AutomationArt/LoraType/README.md

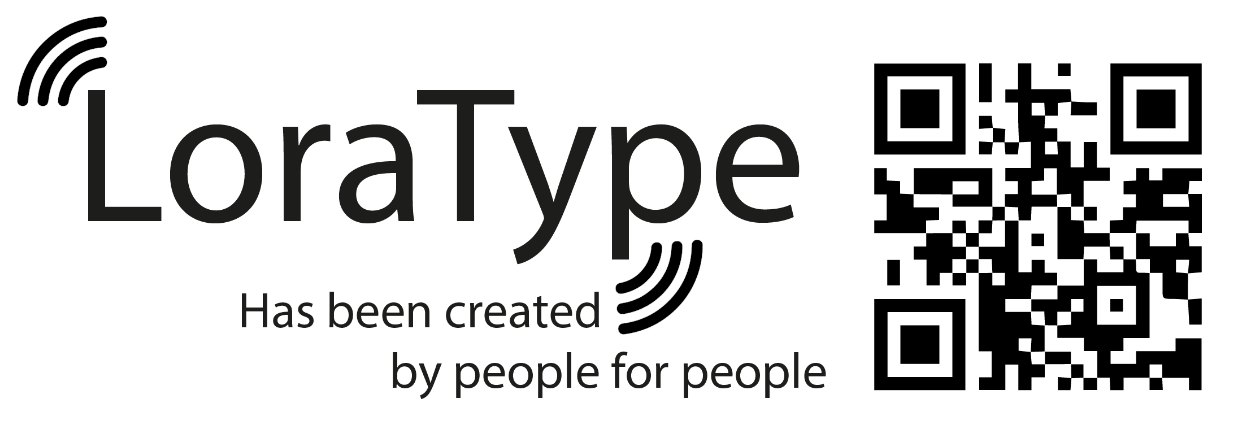
[picture p1: Image/LoraType.png]
LoraType


### NEWS LoraType...| 08.10.2024

Hello everyone! Straight to the point: we've integrated new OTA updates. Now you can update firmware locally, independent of the internet and the availability of an online service. We’ve integrated [ElegantOTA](https://github.com/ayushsharma82/ElegantOTA) (an OTA server runs on the device, and you can conveniently upload your modified firmware — it's made by people for people).
We invite everyone to test, develop, innovate, and especially mesh protocol nerds!
For testing, you can purchase devices at our local store: [shop.automation.art](https://shop.automation.art/products/radio-868mhz-mesendzher-tekstova-ratsiya-loratype-prototip/)

### Previous News

- We are on  [Fosstodon](https://fosstodon.org/@loratype "Fosstodon")  
- We built a second version of the case
- We have assembled a batch of devices (**50 pcs**)
- New video of how it works! [https://youtu.be/M7Vq4bjurBg](https://youtu.be/M7Vq4bjurBg "https://youtu.be/M7Vq4bjurBg")
- We are adding new code to the project 
- We sent the devices to users for testing (USA, Germany, Armenia)
- In contact with @meshtastic, sent them devices to start joint integration 
- We welcome comments and suggestions 😊

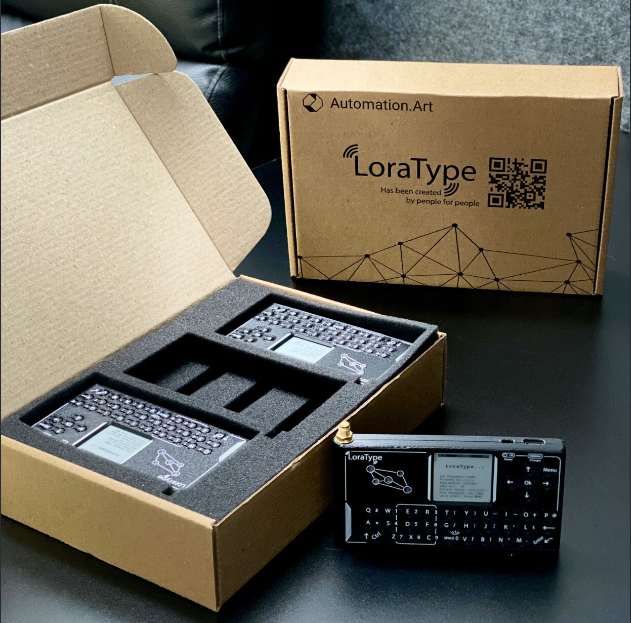
[picture p2: Image/LoratypeNP3.png]
LoraType LoraType2

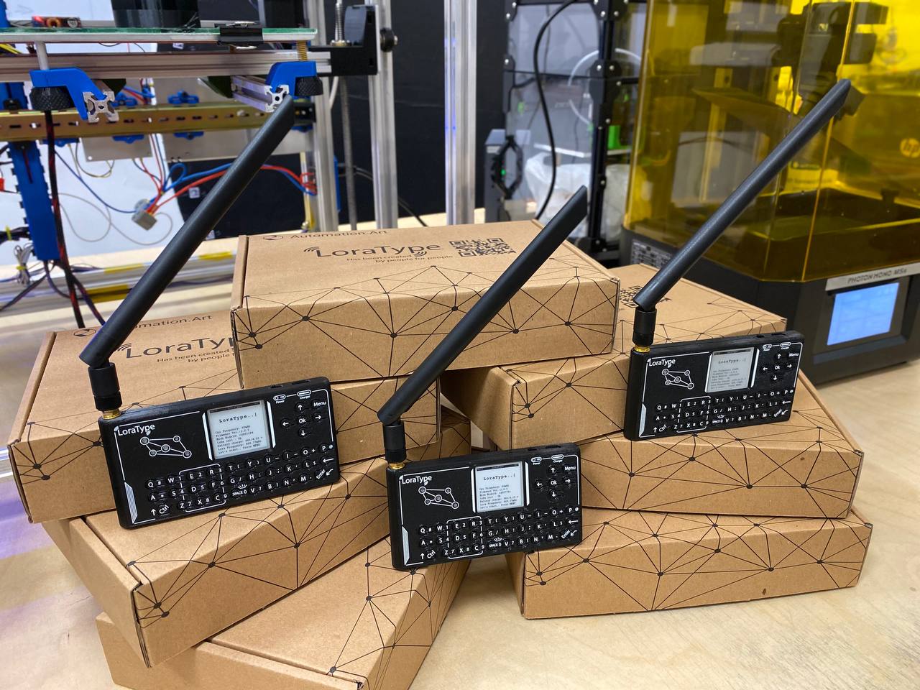
[picture p3: Image/LoraTypeNP1.jpg]
LoraType LoraType1


### LoraType
Our priority is to make the user experience as simple as possible. It only has an on/off button, a widespread QWERTY-keyboard and a cute e-ink display. That’s it. However, in spite of simplicity the Loratype can be used as a tiny PC with possibility for programming and adding new functions thanks to embedded Wі-Fі, Bluetooth and esp32. Welcome on board and feel like home, dear like-minded fellows!

There are some extra features: the LoRa protocol is noise-resistant, and the communication range is about 1 km in a city and up to 7 km in line-of-sight coverage. And of course it is totally free of charge, Loratype has been created not by a Corporation for population, but by people for people. Thus, in any emergency condition, we will honorably stay together!

### How Does it Work?
1. Turn on the device
2. Wait a moment (search for interlocutors in the mesh network)
3. Chat, stay in touch without paying for traffic!

### Device features
- Free of charge (Lora user doesn't need to pay for the service)
- Autonomous device (LoraType to be completely autonomous)
- Independed of internet, 5G, GSM etc. (Stay connected without Internet!)

### Use cases
- During disasters like earthquakes, floods, hurricanes, and fires among others
- Hiking or camping far away from cities, receptions etc
- In a war zone or mass protests (when government could shut down the internet)
- When you need free messaging (your plan is expired or you do not have a mobile data on your phone)

### Security
LoRa contains all the basic building blocks needed and used by any modern wireless technology, and it does so using the AES-128 standard. ([Lora Security](https://lora-alliance.org/wp-content/uploads/2020/11/lorawan_security_whitepaper.pdf "Lora Security"))

------------
### We have gone through several important stages of product development.

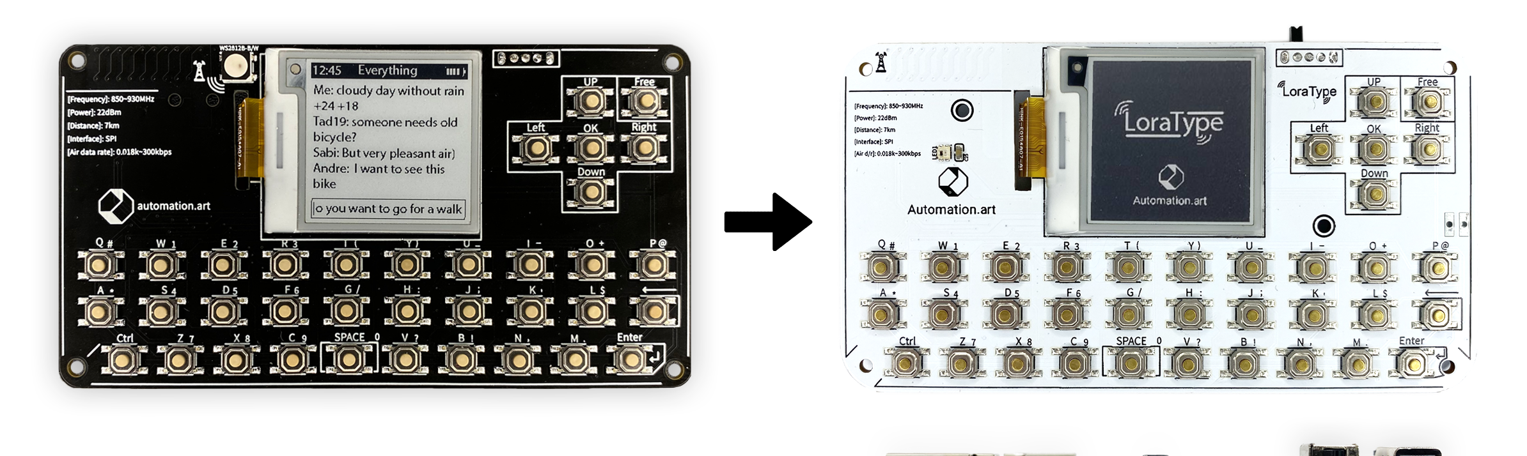
[picture p4: Image/LoraType_v1tov2.png]
LoraType LoraTypePCB


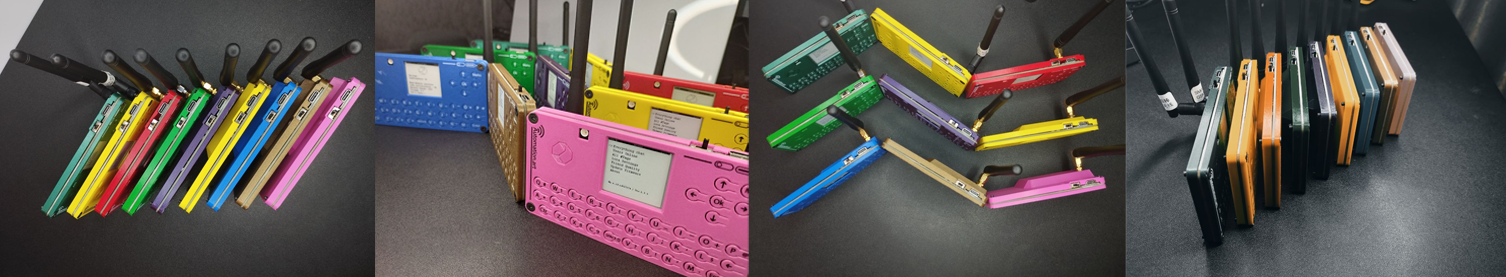
[picture p5: 3D model - Case/V1/LoraType_FirstCase.png]
LoraType_Case LoraTypePCB


------------

### Current PCB release

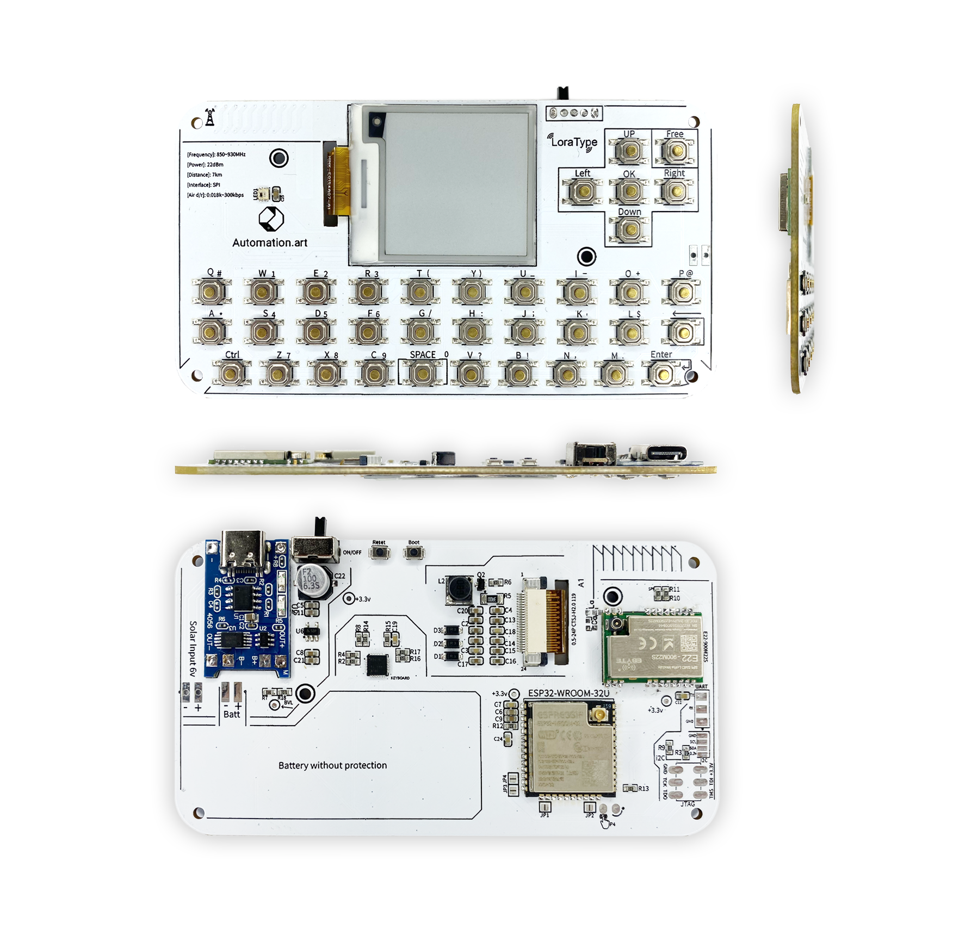
[picture p6: Image/LoraType_PCB.png]
LoraType LoraTypePCB


### Specifications

|  Component | Description  |
| --- | --- |
| **Display**  | Durable low power screen that can store information for up to 6 months without consuming power (1.54 inch e-paper display module partial refresh E-ink screen, [GDEH0154D67](https://www.good-display.com/product/1.54-inch-e-paper-display-module-partial-refresh-E-ink-screen,-GDEH0154D67-208.html "GDEH0154D67")) |
| **Main controller** | The [ESP32](https://www.espressif.com/sites/default/files/documentation/esp32-wroom-32e_esp32-wroom-32ue_datasheet_en.pdf "ESP32") module gives the device great advantages in development and functionality. You only need to replace the firmware over the air |
| **Lora Module**  | The [E22](https://www.ebyte.com/en/product-view-news.aspx?id=437 "E22") series is the first wireless module in China to adopt Semtech's SX1262, SX1268 RF chip. This chip provides a variety of modulation methods, such as LoRaTM and traditional GFSK. Its special LoRaTM modulation method increases the communication distance. |
| **Keyboard** | [TCA8418RTWR](https://www.ti.com/product/TCA8418/part-details/TCA8418RTWR "TCA8418RTWR") Great built-in simultaneous click capabilities. Keyboard with built-in protection against electrostatic discharge |
| **Charger**| [TP4056](http://www.tp4056.com/datasheet/ "TP4056") Proven by time and many users. Has battery protection. Battery will last longer |
| **LDO regulator**  | [AP2112](https://www.digikey.com/en/products/detail/diodes-incorporated/AP2112K-3-3TRG1/4470746 "AP2112") is CMOS low dropout linear regulator 600мА  |
| **ARGB Led**  | [WS2912b-2020](https://www.tme.eu/Document/8b264124130de6e17f8ce807c3210601/WS2812B-2020.pdf "WS2912b-2020") is an intelligent control LED light source  |

##### We used good solutions from Good Display, Espressif, Texas Instruments

### Additional features for the community

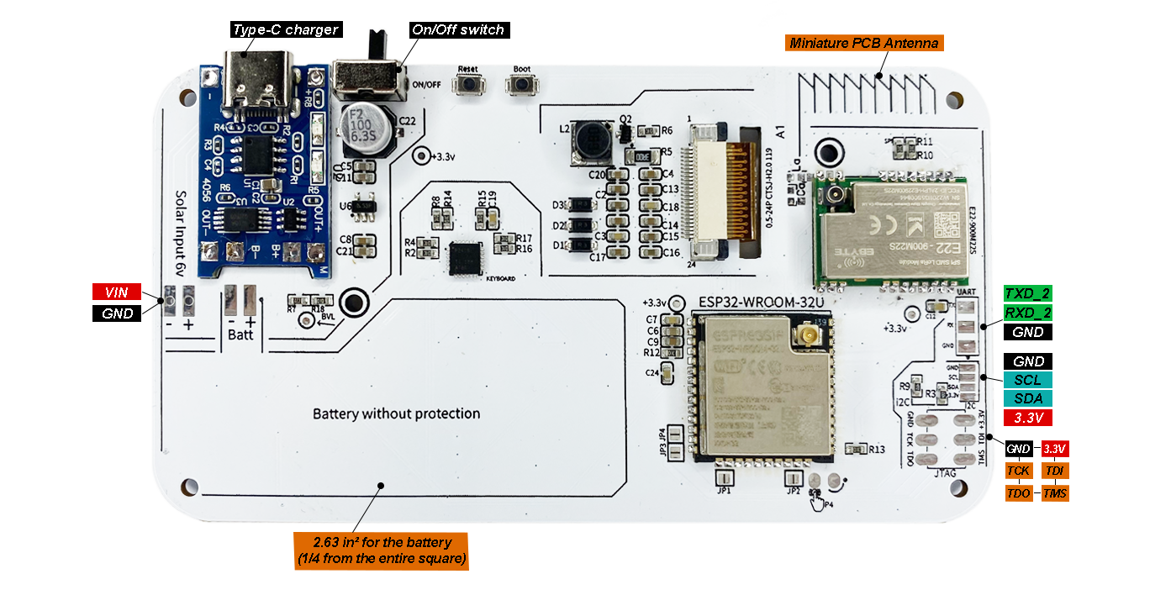
[picture p7: Image/LoraType_ForDIY.png]
LoraTypeForDiy


**For device owners, the ability to add DIY add-ons is available.**
- Fast flash firmware (UART)
- Adding your own sensors to the device (via I2C bus)
- JTAG debugging
- Replaceable battery (Li-po)
- Using integrated antenna
- Connection of external power generators (Energy harvesters)

**Main controller features:**

- Support Wi-Fi + Bluetooth® + Bluetooth LE
- WiFi Standards: FCC/CE/IC/TELEC/KCC/SRRC/NCC
- Protocols: 802.11 b/g/n/d/e/i/k/r (802.11n up to 150Mbps)
- Support Wi-Fi Modes: Client, Access Point, Sniffer, Wi-Fi Direct
- Integrated SPI flash: 4 MB
- Security: WPA/WPA2/WPA2-Enterprise/WPS
- Encryption: AES/RSA/ECC/SHA
- Network protocols: IPv4, IPv6, SSL, TCP/UDP/HTTP/FTP/MQTT
- Software update over the air

Built-in radio module (SX1262) allows additional various radio communication methods ([RadioLibrary](https://github.com/jgromes/RadioLib/tree/master/examples "RadioLibrary")):  [AFSK](https://en.wikipedia.org/wiki/Frequency-shift_keying "AFSK"), [APRS](https://en.wikipedia.org/wiki/Automatic_Packet_Reporting_System "APRS"), [AX25](https://en.wikipedia.org/wiki/AX.25 "AX25"), FSK4, [Hellschreiber](https://en.wikipedia.org/wiki/Hellschreiber "Hellschreiber,"),[ Morse](https://en.wikipedia.org/wiki/Morse_code " Morse"), [RTTY](https://en.wikipedia.org/wiki/Radioteletype "RTTY"), [SSTV](https://en.wikipedia.org/wiki/Slow-scan_television "SSTV")                        

------------
### Comparisons             
| #| LoraType  |  RippleQWERTY  | ArmaChat | LoRa Msg  | ESPboy LORA  |
| --- | --- | --- | --- | --- | --- |
| **Open Source** |  yes |  yes | yes |  yes | yes  |
| **Transceiver** | SX1262  | SX1276  | RFM95W | RFM95W  | SX1278  |
| **Transmit Power** | 22 dbm  | 19.5 dBm | 20 dbm  | 20 dbm  |  30dBm  |
| **Display** | E-Ink  | OLED  | TFT  | TFT |  TFT  |
|  **Battery** | Li-po 1100mA  | It is not specified exactly  | 18650  | 1500mA |  It is not specified exactly  |
|  **Num. of buttons** |  36 |  35  |  30  |  35  |  6  |
|  **Wi-Fi** |  yes |  yes  |  no  |  no  |  yes  |
|  **Bluetooth** | yes  |  yes  | no | no |  no |
|  **Case** |  yes (choice is available+stl) |  yes (+stl)  |  pcb case  | yes (+stl) |  yes (+stl)  |
|  **Dimensions** |  110mm*60mm | not specify |  76mm x 71mm | 70mm*105mm  |  90mm*50mm | 

------------

### Support & Documentation
**This project is open source. We opened all circuits and software**
  
- [Getting Started DIY here](https://github.com/AutomationArt/LoraType/tree/main/GettingStarted "Getting Started DIY here")  :white_check_mark:
- [STL models for cases](https://github.com/AutomationArt/LoraType/tree/main/3D%20model%20-%20Case "STL models for cases") 
- [Components Documentation](https://github.com/AutomationArt/LoraType/tree/main/Documents "Component Documentation") :fire:
- [Software Example](https://github.com/AutomationArt/LoraType/tree/main/Software "Software Example")
- On-line Support
- [Instagram](https://www.instagram.com/automation_art "Instagram") | [Fosstodon](https://fosstodon.org/@loratype "Fosstodon")

<a rel="me" href="https://fosstodon.org/@loratype">Fosstodon</a>
