AutomationArt/LoraType/3D model - Case/README.md

LoraType

### LoraType..|

Cases and models for 3D printing LoraType
