AutomationArt/LoraType/3D model - Case/V1/README.md

LoraType

### LoraType..|

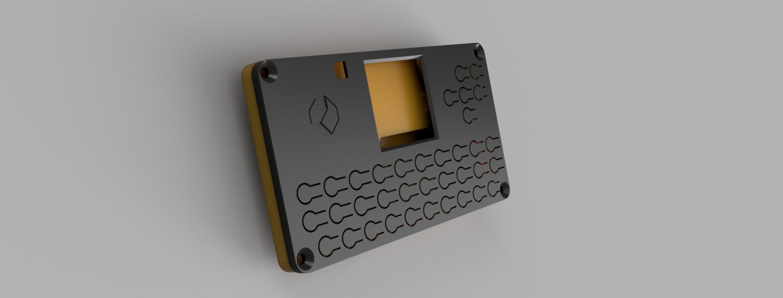
[picture p8: 3D model - Case/V1/Lora 0.2 v2.png]
LoraType Case v1


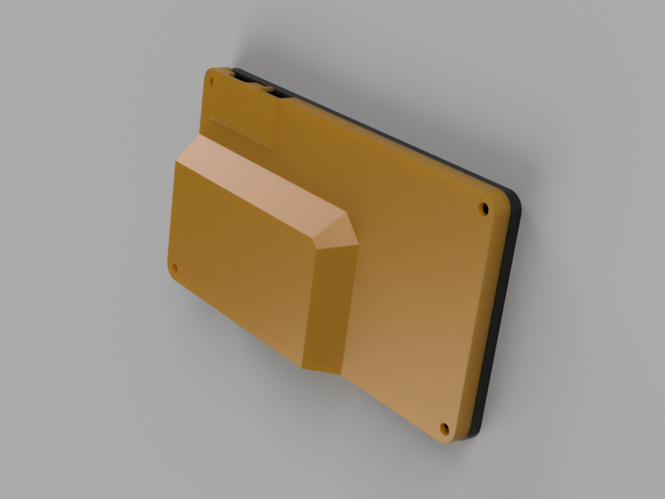
[picture p9: 3D model - Case/V1/Lora 0.2 v21.png]
LoraType Case v1


LoraType Case v1 LoraType Case 3D

[Download STEP file](https://github.com/AutomationArt/LoraType/blob/main/3D%20model%20-%20Case/V1/Lora%200.2%20v2.step "Download STEP file")
