AutomationArt/LoraType/Video/README.md

LoraType
### LoraType..|

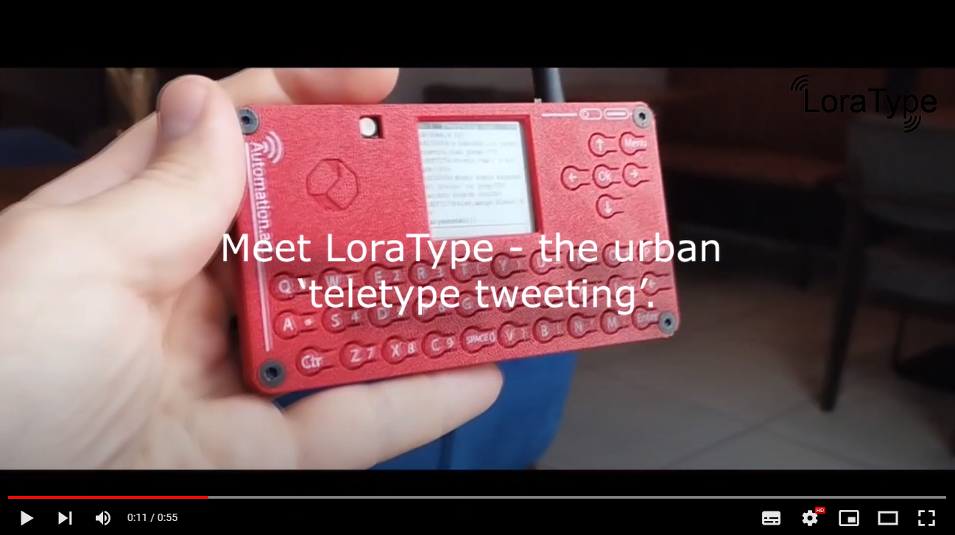
[picture p10: Image/VideoLoraType.png]
LoraType (https://youtu.be/F7qizRmNL4o)
