AutomationArt/LoraType/3D model - Case/V2-Rounded/LoraType_v2_case2.jpg

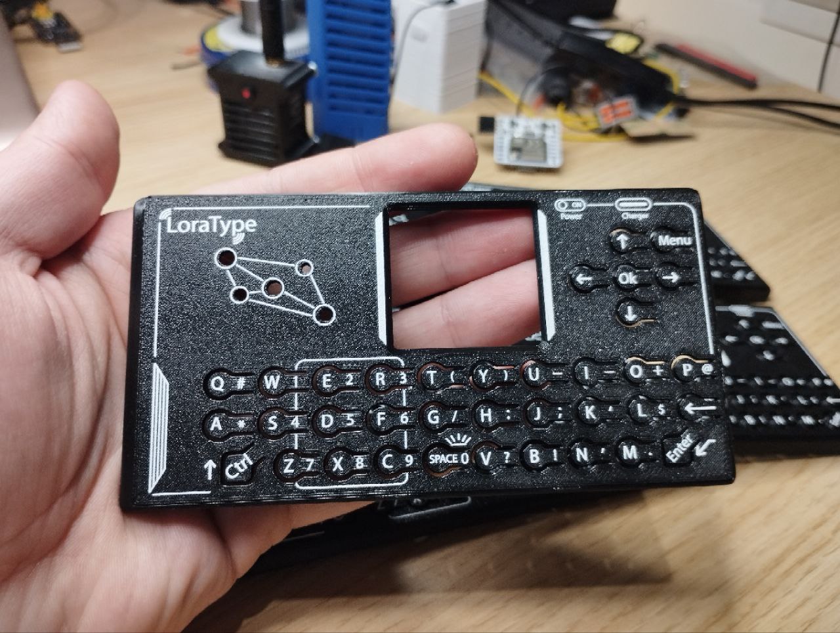
3D model - Case/V2-Rounded/LoraType_v2_case2.jpg
