AutomationArt/LoraType/3D model - Case/V2-Rounded/LoraType_v2_case.jpg

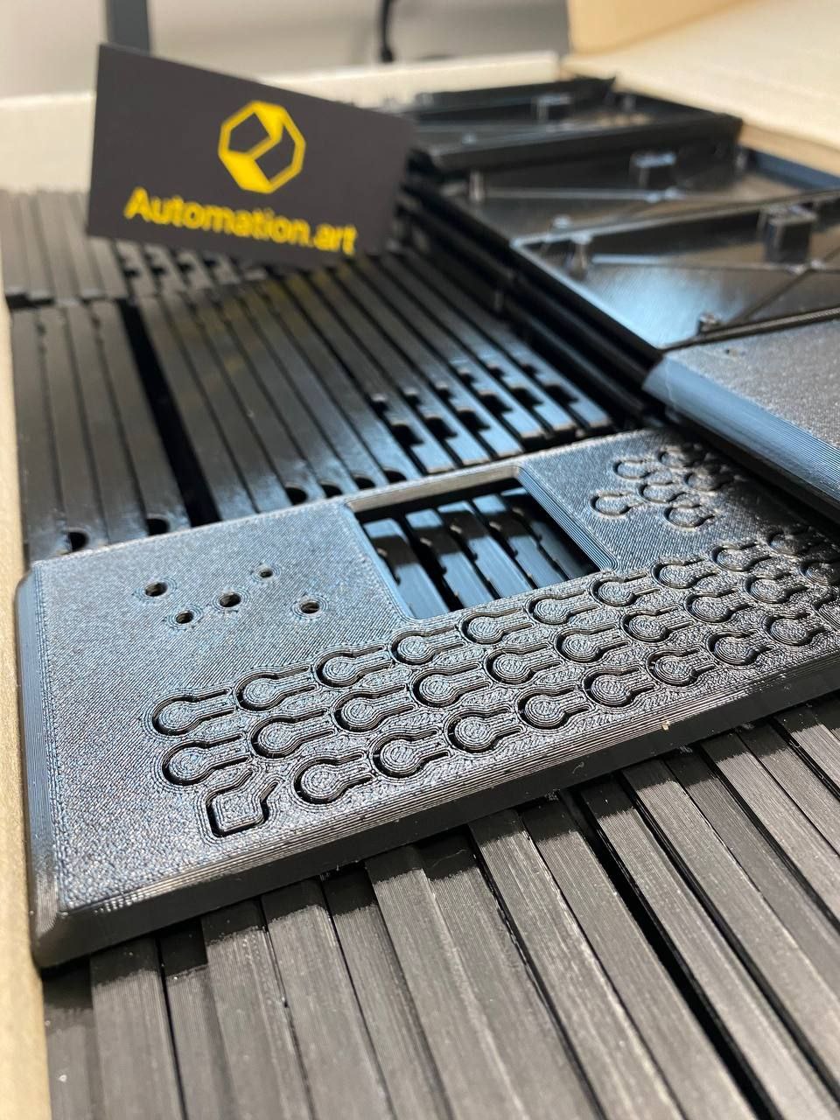
3D model - Case/V2-Rounded/LoraType_v2_case.jpg
