AutomationArt/LoraType/Design stages/v4/LoraType_v4.jpg

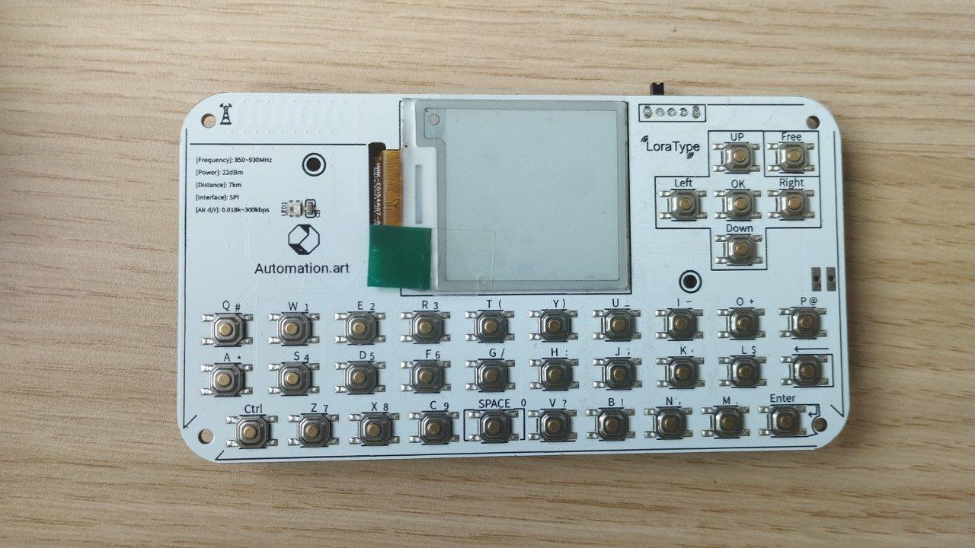
Design stages/v4/LoraType_v4.jpg
