AutomationArt/LoraType/Design stages/v4/LoraType_v4.png

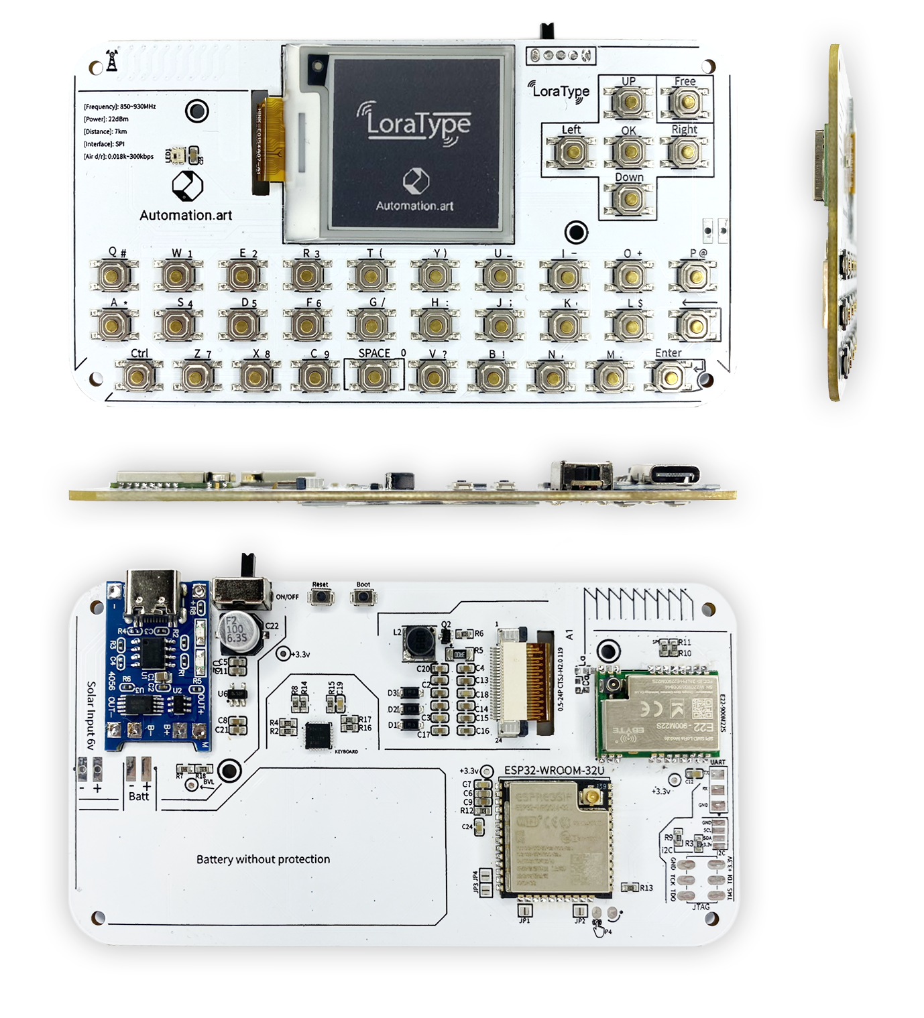
Design stages/v4/LoraType_v4.png
