AutomationArt/LoraType/Design stages/v4/LoraType_v4_box.png

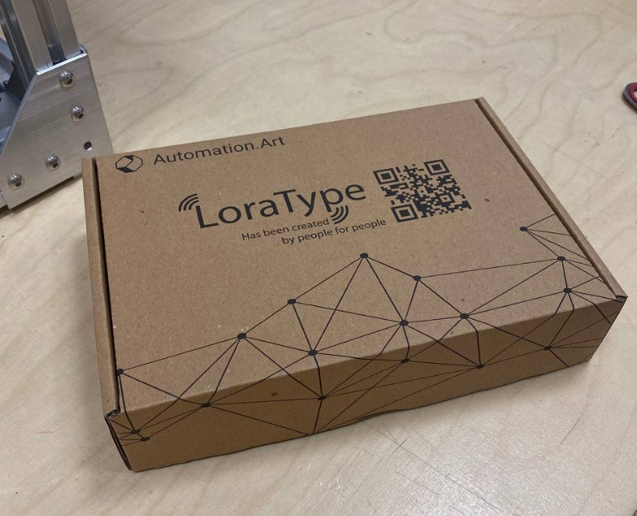
Design stages/v4/LoraType_v4_box.png
