AutomationArt/LoraType/Image/LoraType_PCB_1.png

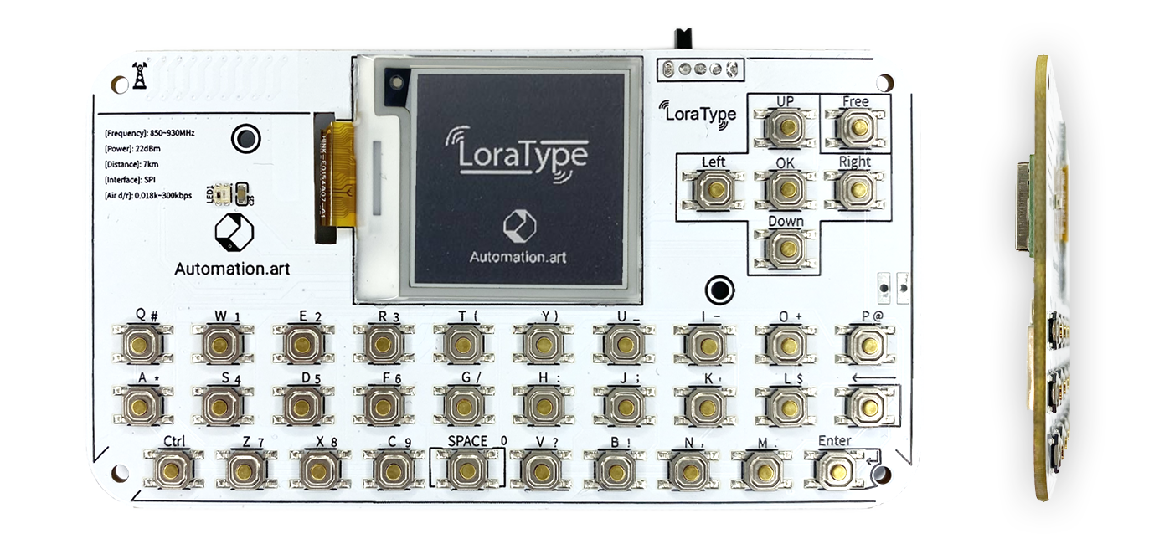
Image/LoraType_PCB_1.png
