AutomationArt/LoraType/Image/LoraType_PCB_3.jpg

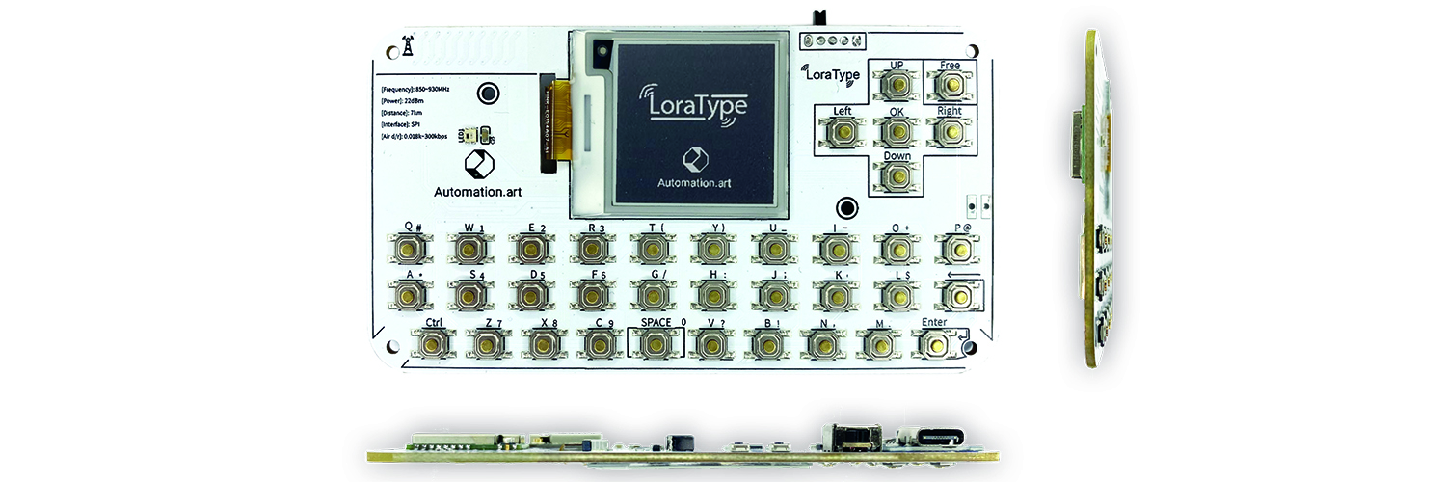
Image/LoraType_PCB_3.jpg
