AutomationArt/LoraType/Image/LoraTypeNP2.jpg

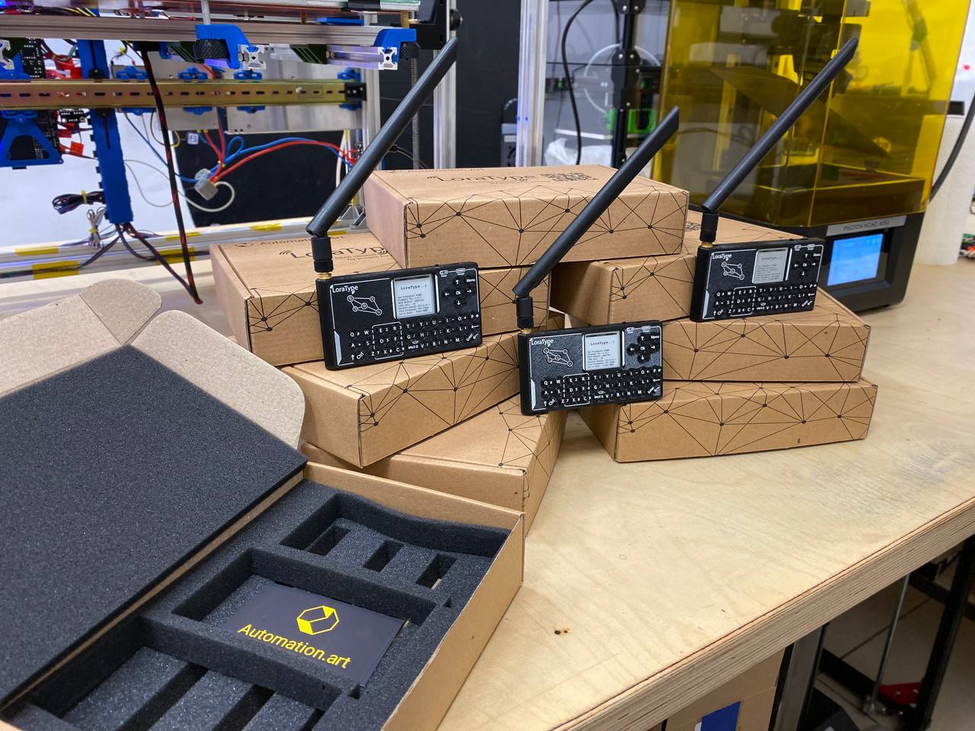
Image/LoraTypeNP2.jpg
