AutomationArt/LoraType/Image/LoratypeNP3.jpeg

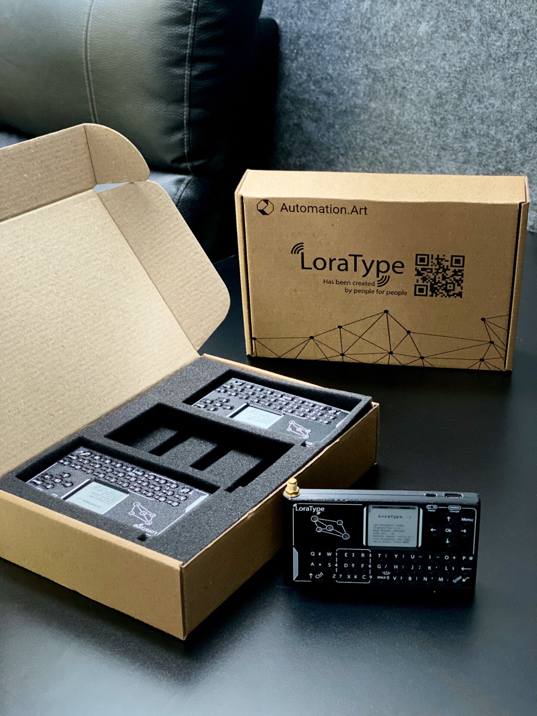
Image/LoratypeNP3.jpeg
