AutomationArt/LoraType/Electronics/BOM_PCB_LoraType.csv

ID | Name | Designator | Footprint | Quantity | Manufacturer Part | Manufacturer | Supplier | Supplier Part | Price | Pins | 3DModel | Contributor | Package Display | Pitch | Resistance | Resistance (Ohms) | link
1 | Boot | SW3 | SW-SMD_L3.1-W2.5-LS4.0 | 1 | GT-TC032A-H015-L1 | G-Switch(品赞) | LCSC | C843684 | 0.028 | 2 | SW-SMD_L3.1-W2.5-LS4.0 | LCSC |  |  |  |  | https://item.szlcsc.com/902796.html
2 | TP4056_MODULE COPY | U2 | TP4056MODULE | 1 |  |  |  |  |  | 6 |  | David Lochlin
3 | 27kΩ | R7 | R0603 | 1 | 0603WAF2702T5E | UniOhm | LCSC | C22967 |  | 2 | R0603_L1.6-W0.8-H0.8 | lcsc |  |  |  | 27K | https://www.mouser.in/datasheet/2/447/PYu_RT_1_to_0_01_RoHS_L_11-1669912.pdf
4 | 100kΩ | R18 | R0603 | 1 | 0603WAF1003T5E | UniOhm | LCSC | C25803 |  | 2 | R0603_L1.6-W0.8-H0.8 | lcsc |  |  |  | 100K | https://www.mouser.in/datasheet/2/447/PYu_RT_1_to_0_01_RoHS_L_11-1669912.pdf
5 | 0.5-24P CTSJ-H2.0 119 | FPC2 | FPC-SMD_24P-P0.50_SHOU-HAN_CTSJ-H2.0 | 1 | 0.5-24P CTSJ-H2.0 119 | SHOU HAN(首韩) | LCSC | C2858299 | 0.014 | 26 | FPC-SMD_P0.50-WS-24P COPY | LCSC |  |  |  |  | https://atta.szlcsc.com/upload/public/pdf/source/20210802/C2858299_F4888E2D4248D884D4956E549F7AA773.pdf
6 | JTAG | J1 | 2X3P-2.54-SMD | 1 |  |  |  |  |  | 6 |  | thedome712
7 | Reset | SW2 | SW-SMD_L3.1-W2.5-LS4.0 | 1 | GT-TC032A-H015-L1 | G-Switch(品赞) | LCSC | C843684 | 0.028 | 2 | SW-SMD_L3.1-W2.5-LS4.0 | LCSC |  |  |  |  | https://item.szlcsc.com/902796.html
8 | SWITCH | ON/OFF | SW-TH_SK12D07VG4 | 1 | SK12D07VG4 | SHOU HAN | LCSC | C393937 | 0.003 | 5 | SW-TH_L8.7-W4.4-H4.0-P2.0 | LCSC | No |  |  |  | https://item.szlcsc.com/372549.html
9 | 10kΩ | R15,R4,R8,R14,R16,R17,R6,R12,R13,R10,R11 | R0603 | 11 | 0603WAF1002T5E | UniOhm | LCSC | C25804 |  | 2 | R0603_L1.6-W0.8-H0.8 | lcsc | Yes |  |  | 10K | https://www.mouser.in/datasheet/2/447/PYu_RT_1_to_0_01_RoHS_L_11-1669912.pdf
10 | 100nF | C19 | C0603 | 1 | CL10B104KA8NNNC | SAMSUNG | LCSC | C1590 |  | 2 | C0603_L1.6-W0.8-H0.8 | lcsc | No |  |  |  | https://item.szlcsc.com/362304.html
11 | 10kΩ | R2 | R0603 | 1 | 0402WAF1002T5E | UniOhm | LCSC | C25804 |  | 2 | R0603_L1.6-W0.8-H0.8 | lcsc | Yes |  |  | 10K | https://www.mouser.in/datasheet/2/447/PYu_RT_1_to_0_01_RoHS_L_11-1669912.pdf
12 | TCA8418RTWR | KEYBOARD | WQFN-24_L4.0-W4.0-P0.50-TL-EP2.5 | 1 | TCA8418RTWR | Texas Instruments | LCSC | C138713 | 0.342 | 25 | WQFN-24_L4.0-W4.0-H0.8-P0.50 | LCSC | No |  |  |  | https://item.szlcsc.com/420260.html
13 | 10uF | C5,C21,C6 | C0603 | 3 | CL10A106KP8NNNC | SAMSUNG | LCSC | C19702 | 0.001 | 2 | C0603_L1.6-W0.8-H0.8 | lcsc | Yes |  |  |  | https://item.szlcsc.com/362304.html
14 | 1uF | C8,C11,C2,C10,C1,C4,C9,C13,C14,C15,C16,C17 | C0603 | 12 | CL10A105KB8NNNC | SAMSUNG | LCSC | C15849 | 0.001 | 2 | C0603_L1.6-W0.8-H0.8 | lcsc | Yes |  |  |  | https://item.szlcsc.com/362304.html
15 | 100uF | C22 | CAP-SMD_BD6.3-L6.6-W6.6-FD | 1 | UZG0J101MCL1GB | Nichicon | LCSC | C134238 | 0.061 | 2 | CAP-SMD_BD6.3-L6.6-W6.6-FD | LCSC | No |  |  |  | https://item.szlcsc.com/265679.html
16 | MBR0530 | D1,D2,D3 | SOD-123_L2.8-W1.8-LS3.7-RD | 3 | MBR0530 | CJ | LCSC | C77336 | 0.005 | 2 | SOD-123_L2.8-W1.8-LS3.7-RD | lcsc | No |  |  |  | https://item.szlcsc.com/301422.html
17 | SI1308EDL-T1-GE3 | Q2 | SOT-323_L2.0-W1.3-P1.30-LS2.1-BR | 1 | SI1308EDL-T1-GE3 | VISHAY(威世) | LCSC | C469327 | 0.114 | 3 | SOT-323_L2.0-W1.3-H1.0-LS2.1-P1.30 | LCSC | No |  |  |  | https://item.szlcsc.com/94230.html
18 | AP2112K-3.3TRG1 | U6 | SOT-25-5_L3.0-W1.8-P0.95-LS3.0-BR | 1 | AP2112K-3.3TRG1 | DIODES | LCSC | C51118 | 0.038 | 5 | SOT-25-5_L3.0-W1.6-H1.3-LS2.8-P0.95 | LCSC | No |  |  |  | https://item.szlcsc.com/70677.html
19 | 68uH | L2 | IND-SMD_L4.7-W4.7 | 1 | SCDS4D18T-680M-S-N | Chilisin Elec | LCSC | C338798 | 0.027 | 2 | IND-SMD_L4.7-W4.7-H2.0 | LCSC |  |  |  |  | https://item.szlcsc.com/198690.html
20 | 100nF | C3,C7,C18,C24,C12,C25 | C0603 | 6 | CL10B104KA8NNNC | SAMSUNG | LCSC | C1590 |  | 2 | C0603_L1.6-W0.8-H0.8 | lcsc | Yes |  |  |  | https://item.szlcsc.com/362304.html
21 | 4.7uF | C20 | C0603 | 1 | CL10A475KO8NNNC | SAMSUNG | LCSC | C19666 | 0.001 | 2 | C0603_L1.6-W0.8-H0.8 | lcsc | Yes |  |  |  | https://item.szlcsc.com/362304.html
22 | 4.7K | R3,R9 | R0603 | 2 | 0603WAJ0472T5E_C145172 | UniOhm | LCSC | C145172 |  | 2 | R0603_L1.6-W0.8-H0.8 | lcsc | Yes |  |  |  | https://www.mouser.in/datasheet/2/447/PYu_RT_1_to_0_01_RoHS_L_11-1669912.pdf
23 | 3Ω | R5 | R1206 | 1 | RT1206FRE073RL | YAGEO | LCSC | C728697 | 0.003 | 2 | R1206_L3.2-W1.6-H0.6 | LCSC | Yes |  | 3Ω |  | https://item.szlcsc.com/311874.html
24 | ESP32-WROOM-32U | U5 | ESP32-WROOM-32U | 1 | ESP32-WROOM-32UE(4MB) | Espressif Systems | LCSC | C701344 | 0.453 | 39 | WIFI-SMD_L19.2-18.0-H3.2-ESP32-WROOM-32UE | Ivan P | No |  |  |  | https://www.espressif.com/sites/default/files/documentation/esp32-wroom-32d_esp32-wroom-32u_datasheet_en.pdf
25 | E22-900M22S | U3 | WIRELM-SMD_E22-900M22S | 1 | E22-900M22S | Chengdu Ebyte Elec Tech | LCSC | C411293 | 1.102 | 22 | WIRELM-SMD_L20.0-W14.0-H3.0-E22-900M22S | LCSC | No |  |  |  | https://item.szlcsc.com/402604.html
26 | LORATYPE_HELICAL PCB ANTENNA 868 | A1 | HELICAL_PCB_ANTENNA_19X12MM_WITH_GND_AND_MATCH | 1 |  |  |  |  |  | 2 |  | piotro2012
27 | 3 PIN SMD HEADER AV | UART | 3 PIN SMD HEADER | 1 |  |  |  |  |  | 3 |  | szegabesz |  | 2.54
28 | WS2812B-2020 | LED1 | LED-SMD_4P-L2.0-W2.0-TL_WS2812B-2020 | 1 | WS2812B-2020 | worldsemi | LCSC | C965555 | 0.017 | 4 | LED-SMD_4P-L2.0-W2.0-H0.8-TL_WS2812B-2020 | LCSC |  |  |  |  | https://item.szlcsc.com/1051115.html?ref=editor&logined=true
29 | UP | 29 | SW-SMD_4P-L5.2-W5.2-P3.70-LS6.5 | 1 | 4*4*1.7Plastic head waterproof,260G, 0.25mm,SMD | BBJ | LCSC | C10852 | 0.003 | 4 | SW-SMD_4P-L5.2-W5.2-H1.5-LS6.4-P3.70 | 立创EDA官方封装库 | No |  |  |  | https://lcsc.com/product-detail/Tactile-Switches_BOOMELE-Boom-Precision-Elec-4-4-1-7_C10852.html
30 | I | 1 | SW-SMD_4P-L5.2-W5.2-P3.70-LS6.5 | 1 | 4*4*1.7Plastic head waterproof,260G, 0.25mm,SMD | BBJ | LCSC | C10852 | 0.003 | 4 | SW-SMD_4P-L5.2-W5.2-H1.5-LS6.4-P3.70 | 立创EDA官方封装库 | No |  |  |  | https://lcsc.com/product-detail/Tactile-Switches_BOOMELE-Boom-Precision-Elec-4-4-1-7_C10852.html
31 | U | 2 | SW-SMD_4P-L5.2-W5.2-P3.70-LS6.5 | 1 | 4*4*1.7Plastic head waterproof,260G, 0.25mm,SMD | BBJ | LCSC | C10852 | 0.003 | 4 | SW-SMD_4P-L5.2-W5.2-H1.5-LS6.4-P3.70 | 立创EDA官方封装库 | No |  |  |  | https://lcsc.com/product-detail/Tactile-Switches_BOOMELE-Boom-Precision-Elec-4-4-1-7_C10852.html
32 | Y | 3 | SW-SMD_4P-L5.2-W5.2-P3.70-LS6.5 | 1 | 4*4*1.7Plastic head waterproof,260G, 0.25mm,SMD | BBJ | LCSC | C10852 | 0.003 | 4 | SW-SMD_4P-L5.2-W5.2-H1.5-LS6.4-P3.70 | 立创EDA官方封装库 | No |  |  |  | https://lcsc.com/product-detail/Tactile-Switches_BOOMELE-Boom-Precision-Elec-4-4-1-7_C10852.html
33 | T | 4 | SW-SMD_4P-L5.2-W5.2-P3.70-LS6.5 | 1 | 4*4*1.7Plastic head waterproof,260G, 0.25mm,SMD | BBJ | LCSC | C10852 | 0.003 | 4 | SW-SMD_4P-L5.2-W5.2-H1.5-LS6.4-P3.70 | 立创EDA官方封装库 | No |  |  |  | https://lcsc.com/product-detail/Tactile-Switches_BOOMELE-Boom-Precision-Elec-4-4-1-7_C10852.html
34 | R | 5 | SW-SMD_4P-L5.2-W5.2-P3.70-LS6.5 | 1 | 4*4*1.7Plastic head waterproof,260G, 0.25mm,SMD | BBJ | LCSC | C10852 | 0.003 | 4 | SW-SMD_4P-L5.2-W5.2-H1.5-LS6.4-P3.70 | 立创EDA官方封装库 | No |  |  |  | https://lcsc.com/product-detail/Tactile-Switches_BOOMELE-Boom-Precision-Elec-4-4-1-7_C10852.html
35 | E | 6 | SW-SMD_4P-L5.2-W5.2-P3.70-LS6.5 | 1 | 4*4*1.7Plastic head waterproof,260G, 0.25mm,SMD | BBJ | LCSC | C10852 | 0.003 | 4 | SW-SMD_4P-L5.2-W5.2-H1.5-LS6.4-P3.70 | 立创EDA官方封装库 | No |  |  |  | https://lcsc.com/product-detail/Tactile-Switches_BOOMELE-Boom-Precision-Elec-4-4-1-7_C10852.html
36 | W | 7 | SW-SMD_4P-L5.2-W5.2-P3.70-LS6.5 | 1 | 4*4*1.7Plastic head waterproof,260G, 0.25mm,SMD | BBJ | LCSC | C10852 | 0.003 | 4 | SW-SMD_4P-L5.2-W5.2-H1.5-LS6.4-P3.70 | 立创EDA官方封装库 | No |  |  |  | https://lcsc.com/product-detail/Tactile-Switches_BOOMELE-Boom-Precision-Elec-4-4-1-7_C10852.html
37 | Q | 8 | SW-SMD_4P-L5.2-W5.2-P3.70-LS6.5 | 1 | 4*4*1.7Plastic head waterproof,260G, 0.25mm,SMD | BBJ | LCSC | C10852 | 0.003 | 4 | SW-SMD_4P-L5.2-W5.2-H1.5-LS6.4-P3.70 | 立创EDA官方封装库 | No |  |  |  | https://lcsc.com/product-detail/Tactile-Switches_BOOMELE-Boom-Precision-Elec-4-4-1-7_C10852.html
38 | K | 9 | SW-SMD_4P-L5.2-W5.2-P3.70-LS6.5 | 1 | 4*4*1.7Plastic head waterproof,260G, 0.25mm,SMD | BBJ | LCSC | C10852 | 0.003 | 4 | SW-SMD_4P-L5.2-W5.2-H1.5-LS6.4-P3.70 | 立创EDA官方封装库 | No |  |  |  | https://lcsc.com/product-detail/Tactile-Switches_BOOMELE-Boom-Precision-Elec-4-4-1-7_C10852.html
39 | J | 10 | SW-SMD_4P-L5.2-W5.2-P3.70-LS6.5 | 1 | 4*4*1.7Plastic head waterproof,260G, 0.25mm,SMD | BBJ | LCSC | C10852 | 0.003 | 4 | SW-SMD_4P-L5.2-W5.2-H1.5-LS6.4-P3.70 | 立创EDA官方封装库 | No |  |  |  | https://lcsc.com/product-detail/Tactile-Switches_BOOMELE-Boom-Precision-Elec-4-4-1-7_C10852.html
40 | H | 11 | SW-SMD_4P-L5.2-W5.2-P3.70-LS6.5 | 1 | 4*4*1.7Plastic head waterproof,260G, 0.25mm,SMD | BBJ | LCSC | C10852 | 0.003 | 4 | SW-SMD_4P-L5.2-W5.2-H1.5-LS6.4-P3.70 | 立创EDA官方封装库 | No |  |  |  | https://lcsc.com/product-detail/Tactile-Switches_BOOMELE-Boom-Precision-Elec-4-4-1-7_C10852.html
41 | G | 12 | SW-SMD_4P-L5.2-W5.2-P3.70-LS6.5 | 1 | 4*4*1.7Plastic head waterproof,260G, 0.25mm,SMD | BBJ | LCSC | C10852 | 0.003 | 4 | SW-SMD_4P-L5.2-W5.2-H1.5-LS6.4-P3.70 | 立创EDA官方封装库 | No |  |  |  | https://lcsc.com/product-detail/Tactile-Switches_BOOMELE-Boom-Precision-Elec-4-4-1-7_C10852.html
42 | F | 13 | SW-SMD_4P-L5.2-W5.2-P3.70-LS6.5 | 1 | 4*4*1.7Plastic head waterproof,260G, 0.25mm,SMD | BBJ | LCSC | C10852 | 0.003 | 4 | SW-SMD_4P-L5.2-W5.2-H1.5-LS6.4-P3.70 | 立创EDA官方封装库 | No |  |  |  | https://lcsc.com/product-detail/Tactile-Switches_BOOMELE-Boom-Precision-Elec-4-4-1-7_C10852.html
43 | D | 14 | SW-SMD_4P-L5.2-W5.2-P3.70-LS6.5 | 1 | 4*4*1.7Plastic head waterproof,260G, 0.25mm,SMD | BBJ | LCSC | C10852 | 0.003 | 4 | SW-SMD_4P-L5.2-W5.2-H1.5-LS6.4-P3.70 | 立创EDA官方封装库 | No |  |  |  | https://lcsc.com/product-detail/Tactile-Switches_BOOMELE-Boom-Precision-Elec-4-4-1-7_C10852.html
44 | S | 15 | SW-SMD_4P-L5.2-W5.2-P3.70-LS6.5 | 1 | 4*4*1.7Plastic head waterproof,260G, 0.25mm,SMD | BBJ | LCSC | C10852 | 0.003 | 4 | SW-SMD_4P-L5.2-W5.2-H1.5-LS6.4-P3.70 | 立创EDA官方封装库 | No |  |  |  | https://lcsc.com/product-detail/Tactile-Switches_BOOMELE-Boom-Precision-Elec-4-4-1-7_C10852.html
45 | A | 16 | SW-SMD_4P-L5.2-W5.2-P3.70-LS6.5 | 1 | 4*4*1.7Plastic head waterproof,260G, 0.25mm,SMD | BBJ | LCSC | C10852 | 0.003 | 4 | SW-SMD_4P-L5.2-W5.2-H1.5-LS6.4-P3.70 | 立创EDA官方封装库 | No |  |  |  | https://lcsc.com/product-detail/Tactile-Switches_BOOMELE-Boom-Precision-Elec-4-4-1-7_C10852.html
46 | Down | 17 | SW-SMD_4P-L5.2-W5.2-P3.70-LS6.5 | 1 | 4*4*1.7Plastic head waterproof,260G, 0.25mm,SMD | BBJ | LCSC | C10852 | 0.003 | 4 | SW-SMD_4P-L5.2-W5.2-H1.5-LS6.4-P3.70 | 立创EDA官方封装库 | No |  |  |  | https://lcsc.com/product-detail/Tactile-Switches_BOOMELE-Boom-Precision-Elec-4-4-1-7_C10852.html
47 | B | 18 | SW-SMD_4P-L5.2-W5.2-P3.70-LS6.5 | 1 | 4*4*1.7Plastic head waterproof,260G, 0.25mm,SMD | BBJ | LCSC | C10852 | 0.003 | 4 | SW-SMD_4P-L5.2-W5.2-H1.5-LS6.4-P3.70 | 立创EDA官方封装库 | No |  |  |  | https://lcsc.com/product-detail/Tactile-Switches_BOOMELE-Boom-Precision-Elec-4-4-1-7_C10852.html
48 | V | 19 | SW-SMD_4P-L5.2-W5.2-P3.70-LS6.5 | 1 | 4*4*1.7Plastic head waterproof,260G, 0.25mm,SMD | BBJ | LCSC | C10852 | 0.003 | 4 | SW-SMD_4P-L5.2-W5.2-H1.5-LS6.4-P3.70 | 立创EDA官方封装库 | No |  |  |  | https://lcsc.com/product-detail/Tactile-Switches_BOOMELE-Boom-Precision-Elec-4-4-1-7_C10852.html
49 | SPACE | 20 | SW-SMD_4P-L5.2-W5.2-P3.70-LS6.5 | 1 | 4*4*1.7Plastic head waterproof,260G, 0.25mm,SMD | BBJ | LCSC | C10852 | 0.003 | 4 | SW-SMD_4P-L5.2-W5.2-H1.5-LS6.4-P3.70 | 立创EDA官方封装库 | No |  |  |  | https://lcsc.com/product-detail/Tactile-Switches_BOOMELE-Boom-Precision-Elec-4-4-1-7_C10852.html
50 | C | 21 | SW-SMD_4P-L5.2-W5.2-P3.70-LS6.5 | 1 | 4*4*1.7Plastic head waterproof,260G, 0.25mm,SMD | BBJ | LCSC | C10852 | 0.003 | 4 | SW-SMD_4P-L5.2-W5.2-H1.5-LS6.4-P3.70 | 立创EDA官方封装库 | No |  |  |  | https://lcsc.com/product-detail/Tactile-Switches_BOOMELE-Boom-Precision-Elec-4-4-1-7_C10852.html
51 | X | 22 | SW-SMD_4P-L5.2-W5.2-P3.70-LS6.5 | 1 | 4*4*1.7Plastic head waterproof,260G, 0.25mm,SMD | BBJ | LCSC | C10852 | 0.003 | 4 | SW-SMD_4P-L5.2-W5.2-H1.5-LS6.4-P3.70 | 立创EDA官方封装库 | No |  |  |  | https://lcsc.com/product-detail/Tactile-Switches_BOOMELE-Boom-Precision-Elec-4-4-1-7_C10852.html
52 | Z | 23 | SW-SMD_4P-L5.2-W5.2-P3.70-LS6.5 | 1 | 4*4*1.7Plastic head waterproof,260G, 0.25mm,SMD | BBJ | LCSC | C10852 | 0.003 | 4 | SW-SMD_4P-L5.2-W5.2-H1.5-LS6.4-P3.70 | 立创EDA官方封装库 | No |  |  |  | https://lcsc.com/product-detail/Tactile-Switches_BOOMELE-Boom-Precision-Elec-4-4-1-7_C10852.html
53 | N | 24 | SW-SMD_4P-L5.2-W5.2-P3.70-LS6.5 | 1 | 4*4*1.7Plastic head waterproof,260G, 0.25mm,SMD | BBJ | LCSC | C10852 | 0.003 | 4 | SW-SMD_4P-L5.2-W5.2-H1.5-LS6.4-P3.70 | 立创EDA官方封装库 | No |  |  |  | https://lcsc.com/product-detail/Tactile-Switches_BOOMELE-Boom-Precision-Elec-4-4-1-7_C10852.html
54 | OK | 25 | SW-SMD_4P-L5.2-W5.2-P3.70-LS6.5 | 1 | 4*4*1.7Plastic head waterproof,260G, 0.25mm,SMD | BBJ | LCSC | C10852 | 0.003 | 4 | SW-SMD_4P-L5.2-W5.2-H1.5-LS6.4-P3.70 | 立创EDA官方封装库 | No |  |  |  | https://lcsc.com/product-detail/Tactile-Switches_BOOMELE-Boom-Precision-Elec-4-4-1-7_C10852.html
55 | Right | 26 | SW-SMD_4P-L5.2-W5.2-P3.70-LS6.5 | 1 | 4*4*1.7Plastic head waterproof,260G, 0.25mm,SMD | BBJ | LCSC | C10852 | 0.003 | 4 | SW-SMD_4P-L5.2-W5.2-H1.5-LS6.4-P3.70 | 立创EDA官方封装库 | No |  |  |  | https://lcsc.com/product-detail/Tactile-Switches_BOOMELE-Boom-Precision-Elec-4-4-1-7_C10852.html
56 | O | 27 | SW-SMD_4P-L5.2-W5.2-P3.70-LS6.5 | 1 | 4*4*1.7Plastic head waterproof,260G, 0.25mm,SMD | BBJ | LCSC | C10852 | 0.003 | 4 | SW-SMD_4P-L5.2-W5.2-H1.5-LS6.4-P3.70 | 立创EDA官方封装库 | No |  |  |  | https://lcsc.com/product-detail/Tactile-Switches_BOOMELE-Boom-Precision-Elec-4-4-1-7_C10852.html
57 | Left | 28 | SW-SMD_4P-L5.2-W5.2-P3.70-LS6.5 | 1 | 4*4*1.7Plastic head waterproof,260G, 0.25mm,SMD | BBJ | LCSC | C10852 | 0.003 | 4 | SW-SMD_4P-L5.2-W5.2-H1.5-LS6.4-P3.70 | 立创EDA官方封装库 | No |  |  |  | https://lcsc.com/product-detail/Tactile-Switches_BOOMELE-Boom-Precision-Elec-4-4-1-7_C10852.html
58 | L | 30 | SW-SMD_4P-L5.2-W5.2-P3.70-LS6.5 | 1 | 4*4*1.7Plastic head waterproof,260G, 0.25mm,SMD | BBJ | LCSC | C10852 | 0.003 | 4 | SW-SMD_4P-L5.2-W5.2-H1.5-LS6.4-P3.70 | 立创EDA官方封装库 | No |  |  |  | https://lcsc.com/product-detail/Tactile-Switches_BOOMELE-Boom-Precision-Elec-4-4-1-7_C10852.html
59 | M | 31 | SW-SMD_4P-L5.2-W5.2-P3.70-LS6.5 | 1 | 4*4*1.7Plastic head waterproof,260G, 0.25mm,SMD | BBJ | LCSC | C10852 | 0.003 | 4 | SW-SMD_4P-L5.2-W5.2-H1.5-LS6.4-P3.70 | 立创EDA官方封装库 | No |  |  |  | https://lcsc.com/product-detail/Tactile-Switches_BOOMELE-Boom-Precision-Elec-4-4-1-7_C10852.html
60 | Ctrl | 32 | SW-SMD_4P-L5.2-W5.2-P3.70-LS6.5 | 1 | 4*4*1.7Plastic head waterproof,260G, 0.25mm,SMD | BBJ | LCSC | C10852 | 0.003 | 4 | SW-SMD_4P-L5.2-W5.2-H1.5-LS6.4-P3.70 | 立创EDA官方封装库 | No |  |  |  | https://lcsc.com/product-detail/Tactile-Switches_BOOMELE-Boom-Precision-Elec-4-4-1-7_C10852.html
61 | Free | 33 | SW-SMD_4P-L5.2-W5.2-P3.70-LS6.5 | 1 | 4*4*1.7Plastic head waterproof,260G, 0.25mm,SMD | BBJ | LCSC | C10852 | 0.003 | 4 | SW-SMD_4P-L5.2-W5.2-H1.5-LS6.4-P3.70 | 立创EDA官方封装库 | No |  |  |  | https://lcsc.com/product-detail/Tactile-Switches_BOOMELE-Boom-Precision-Elec-4-4-1-7_C10852.html
62 | Backspace | 34 | SW-SMD_4P-L5.2-W5.2-P3.70-LS6.5 | 1 | 4*4*1.7Plastic head waterproof,260G, 0.25mm,SMD | BBJ | LCSC | C10852 | 0.003 | 4 | SW-SMD_4P-L5.2-W5.2-H1.5-LS6.4-P3.70 | 立创EDA官方封装库 | No |  |  |  | https://lcsc.com/product-detail/Tactile-Switches_BOOMELE-Boom-Precision-Elec-4-4-1-7_C10852.html
63 | P | 35 | SW-SMD_4P-L5.2-W5.2-P3.70-LS6.5 | 1 | 4*4*1.7Plastic head waterproof,260G, 0.25mm,SMD | BBJ | LCSC | C10852 | 0.003 | 4 | SW-SMD_4P-L5.2-W5.2-H1.5-LS6.4-P3.70 | 立创EDA官方封装库 | No |  |  |  | https://lcsc.com/product-detail/Tactile-Switches_BOOMELE-Boom-Precision-Elec-4-4-1-7_C10852.html
64 | Enter | 36 | SW-SMD_4P-L5.2-W5.2-P3.70-LS6.5 | 1 | UK-B0228-G5-160-JZ | USAKRO | LCSC | C10852 | 0.003 | 4 | SW-SMD_4P-L5.2-W5.2-H1.5-LS6.4-P3.70 | 立创EDA官方封装库 | No |  |  |  | https://lcsc.com/product-detail/Tactile-Switches_BOOMELE-Boom-Precision-Elec-4-4-1-7_C10852.html
65 | E-INK 1.54 IN COPY | U7 | 123TST | 1 |  |  |  |  |  |  |  | Isaac Crawford Poxon
