AutomationArt/LoraType/3D model - Case/V1/Lora 0.2 v2.step

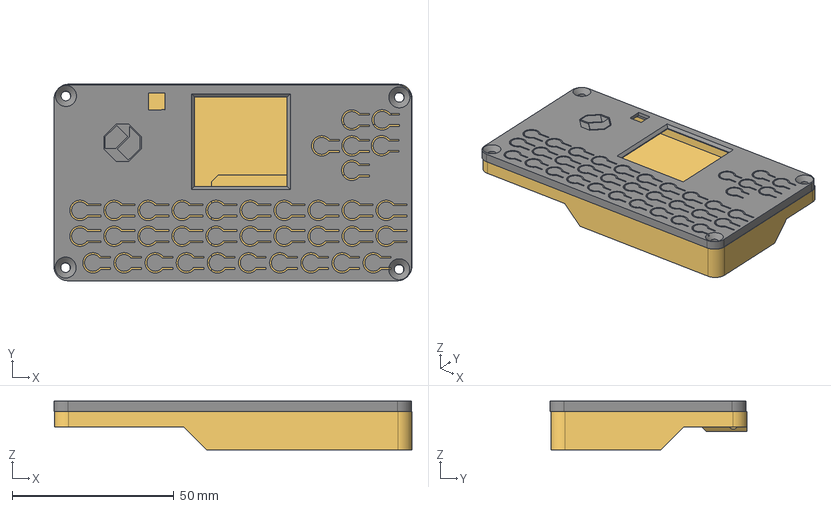
[picture p20: CAD file, 2023-01-20]
3D model - Case/V1/Lora 0.2 v2.step
110.8 x 60.8 x 15.1 mm
BackWithCase v1
TopShort v1
