AutomationArt/LoraType/Electronics/Schematic_LoraType.pdf

Great built-in simultaneous click capabilities. Keyboard with built-in protection against electrostatic discharge.

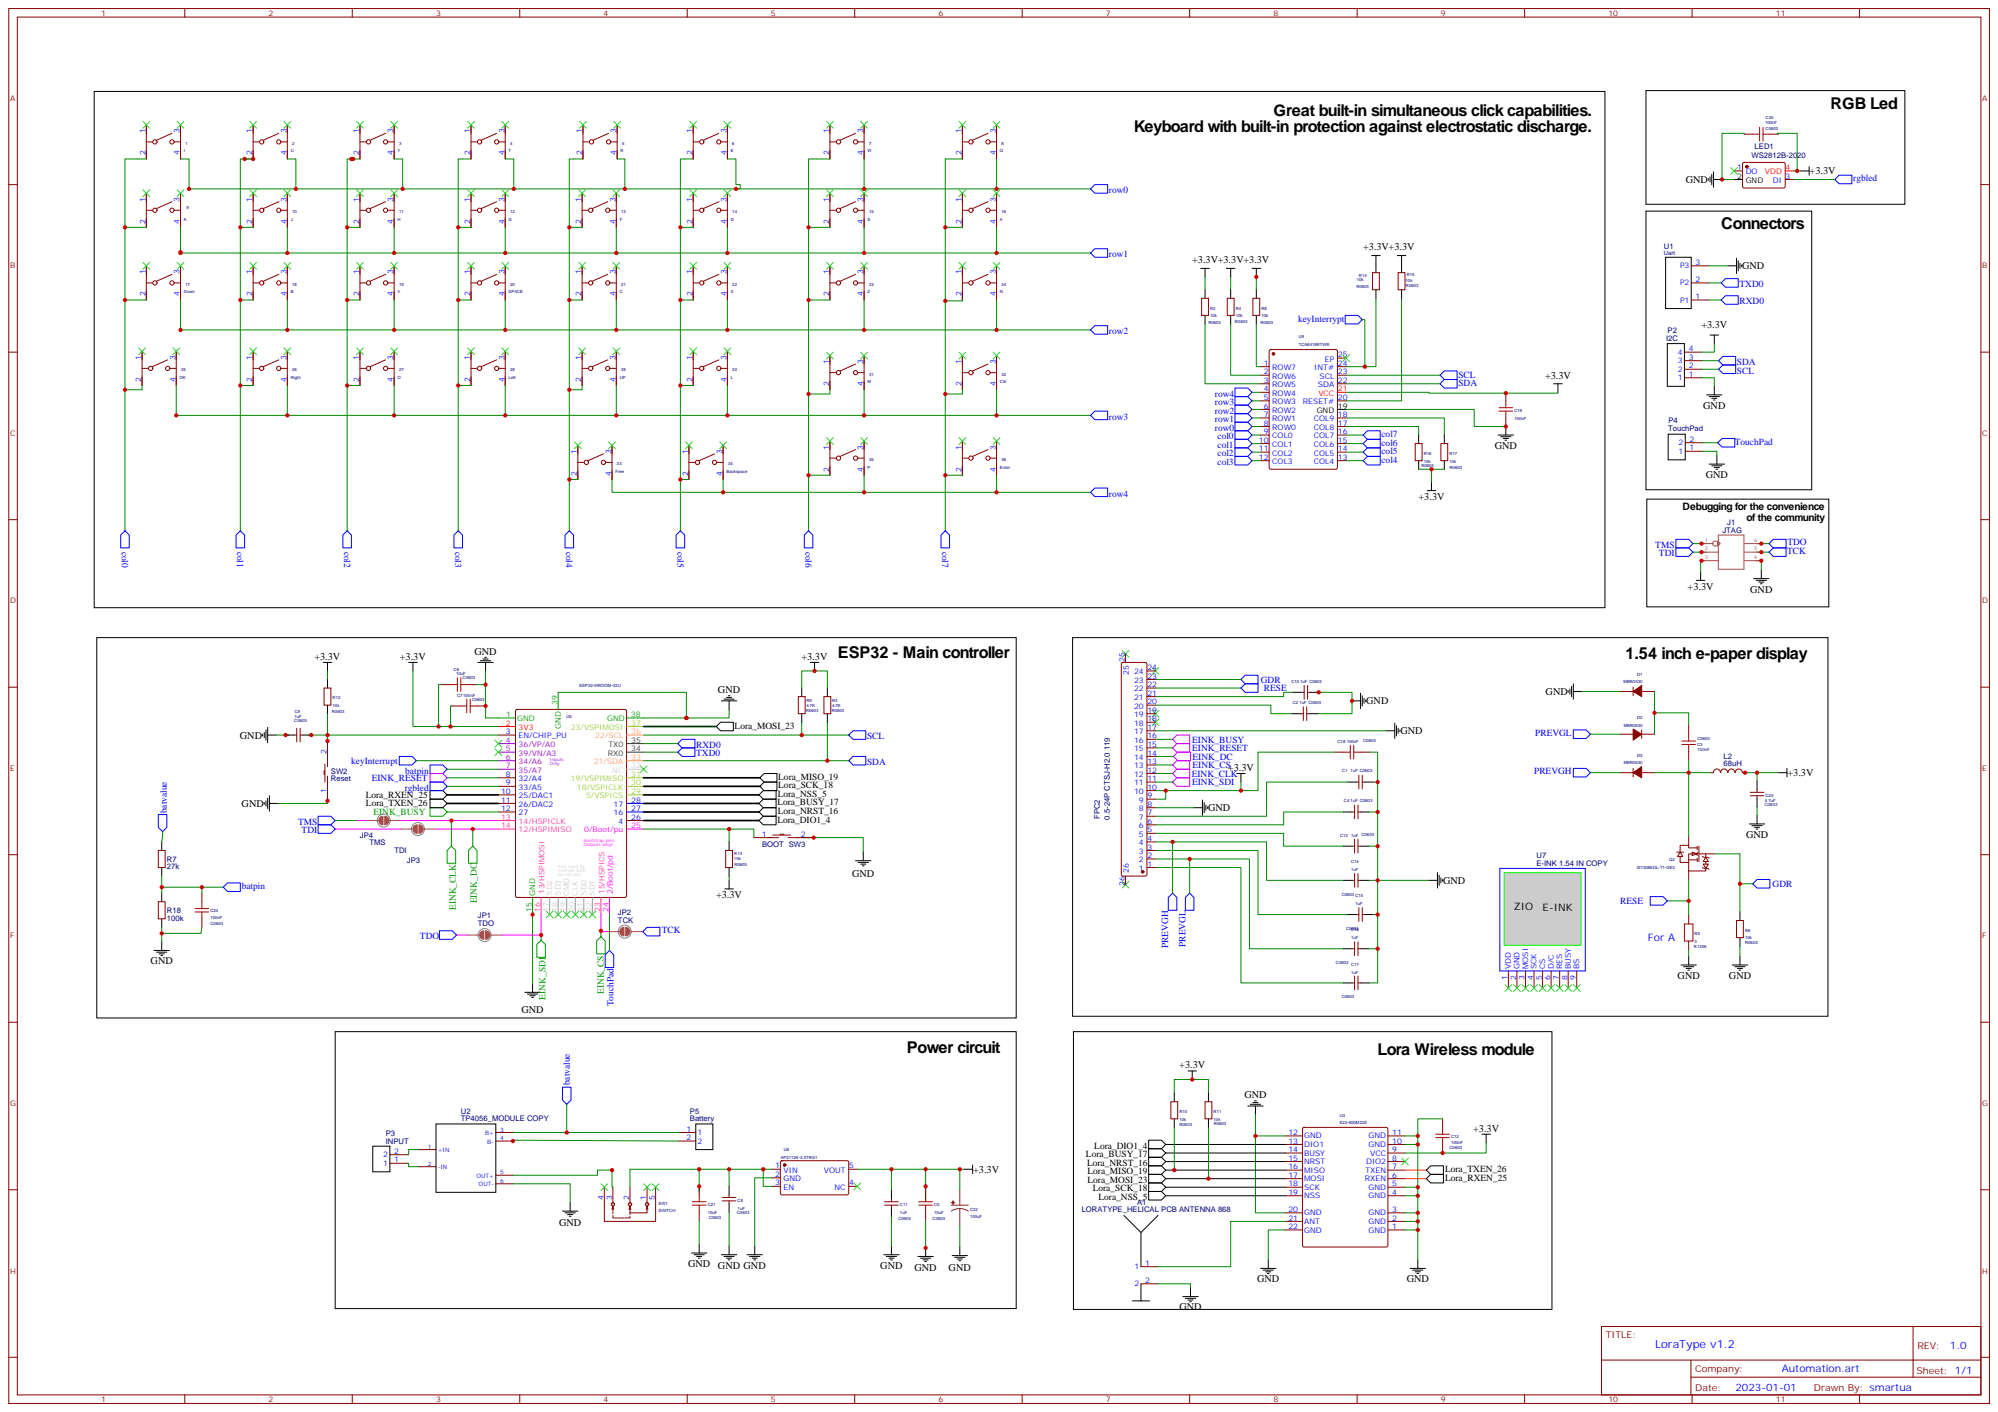
[picture p23: page 1]

Debugging for the convenience
