AutomationArt/LoraType/Software/src/ledFunction.h

// Led interactive

int LedStart(bool ledIndicate); 
int LedLoraWarning(bool);
int LedSystemWarning();
int clearLed();
int LedUpperCase(bool state);
int LedLoraInputMess(bool state);
int LedSystemStart();
int heartLed();
