AutomationArt/LoraType/(commit log)

2023-01-18 First commit. Work chats
    [min_spiffs.csv]
2023-01-20 Full description
    [BOM_PCB_LoraType.csv, Lora 0.2 v2.step, min_spiffs.csv]
2023-04-30 Changes in the code for the new board
2023-05-14 Individual chat fix and etc.
    [main.cpp, main.h]
